kanta/STEP400/hardware/step400_test002_schematics.pdf

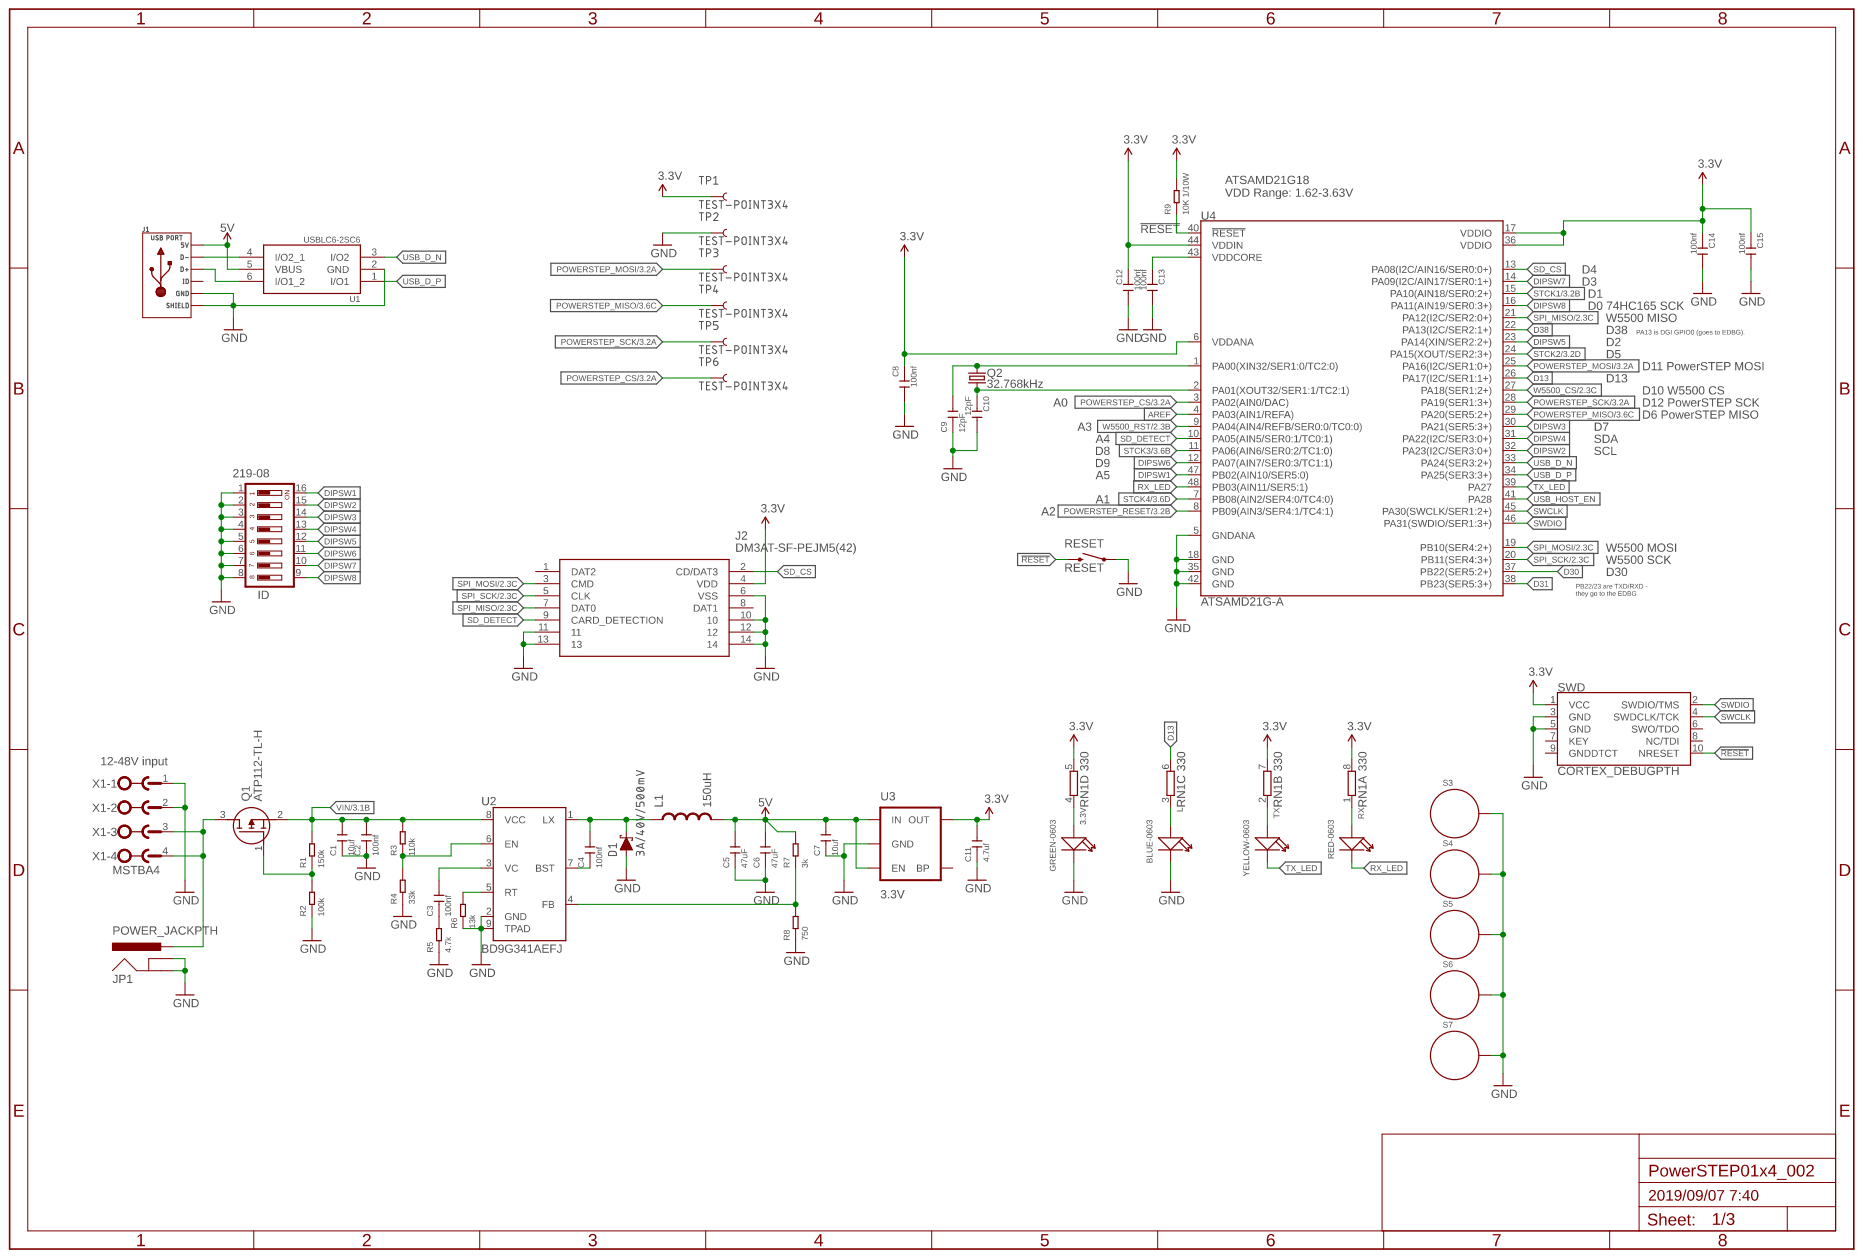
[picture p1: page 1]

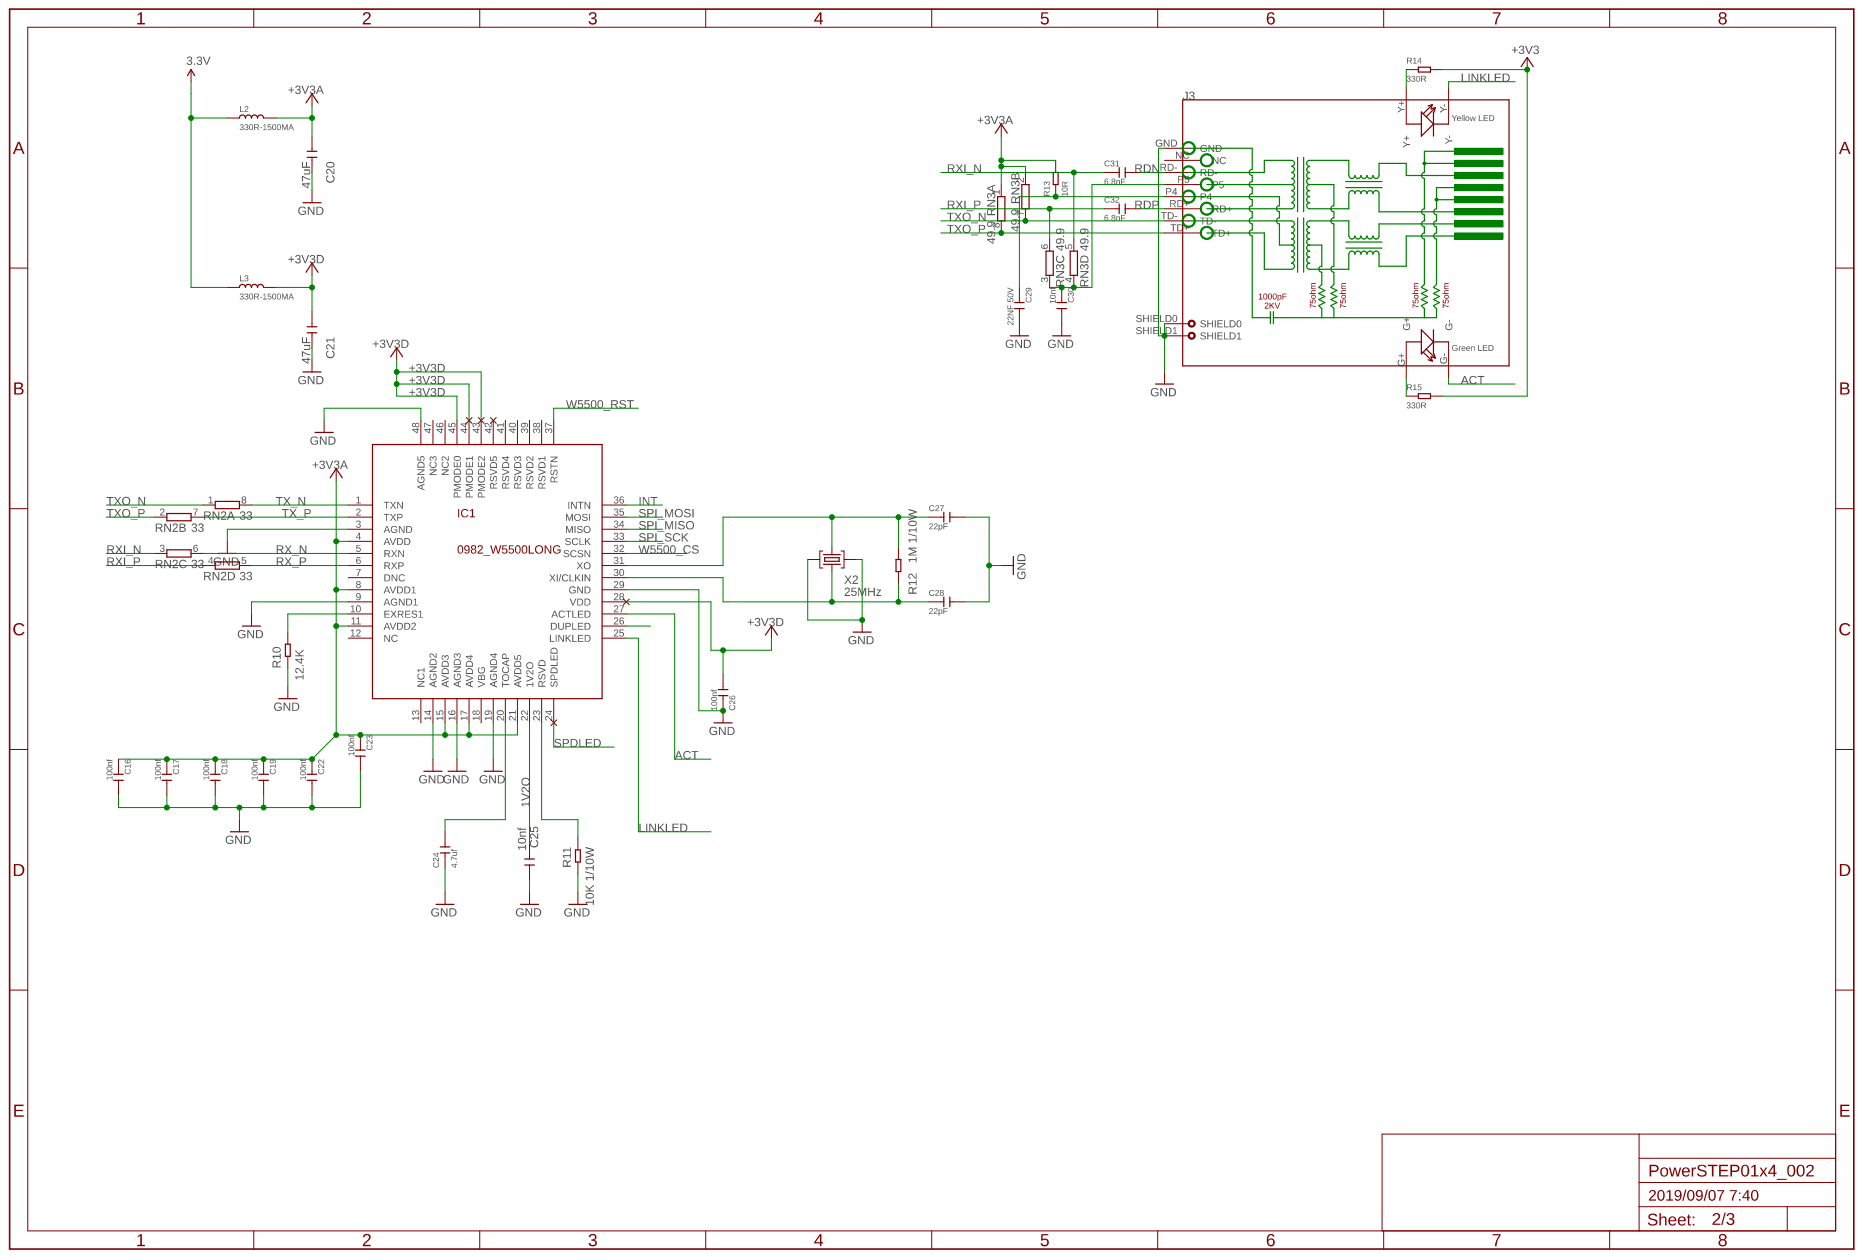
[picture p2: page 2]

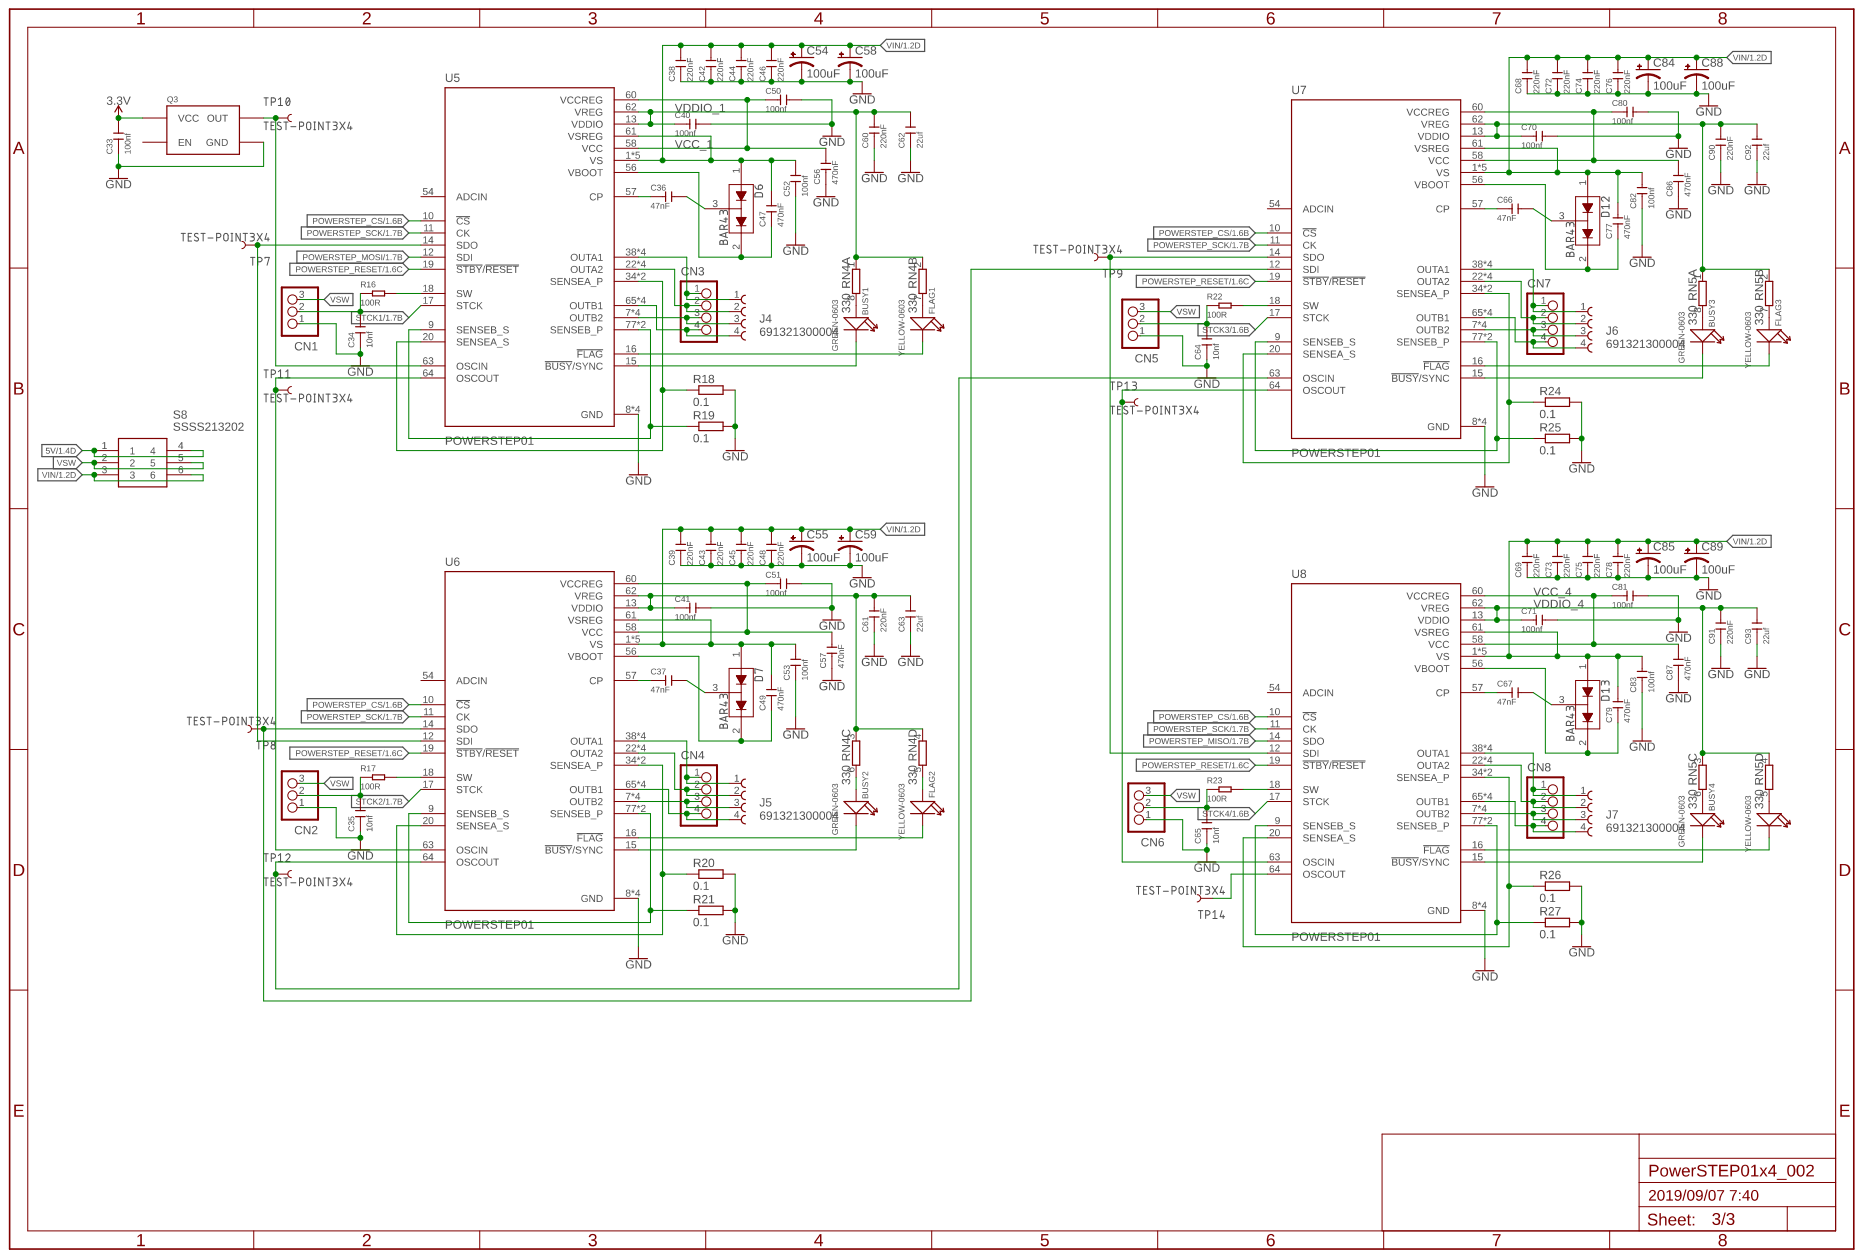
[picture p3: page 3]
