kanta/STEP400/hardware/stepper_quad_PowerSTEP01_bom.pdf

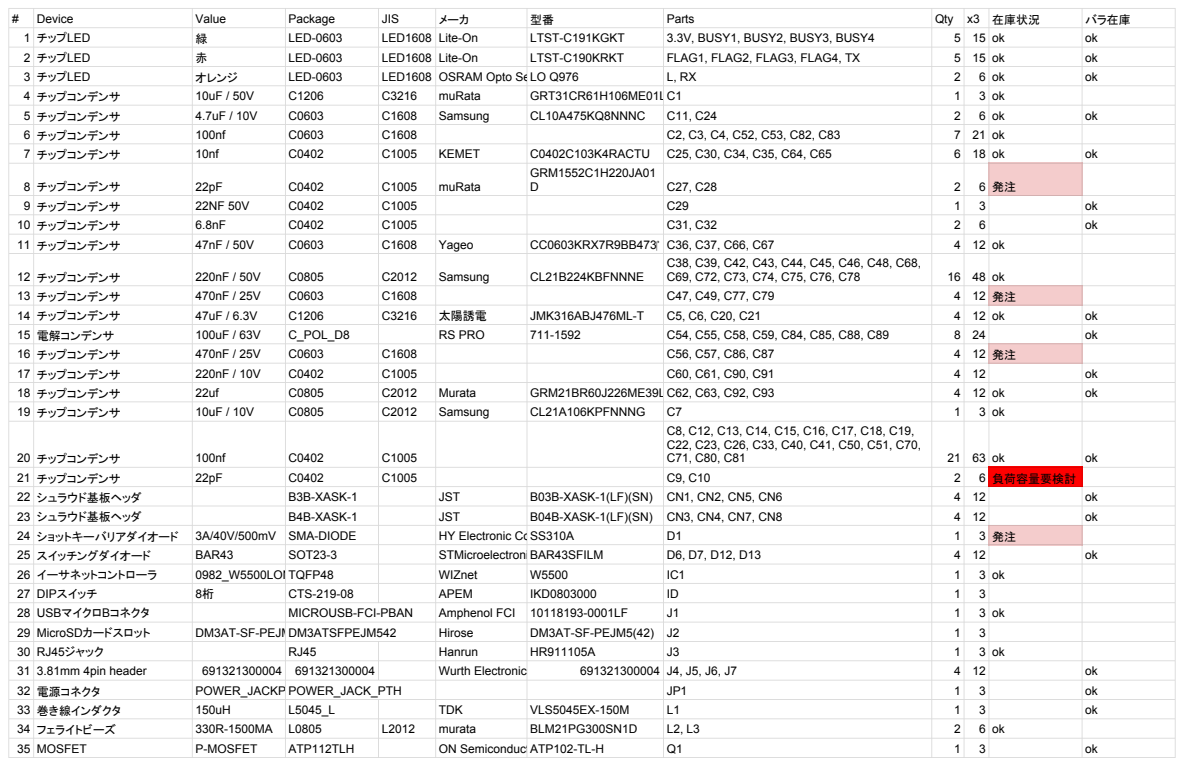
[picture p4: page 1]

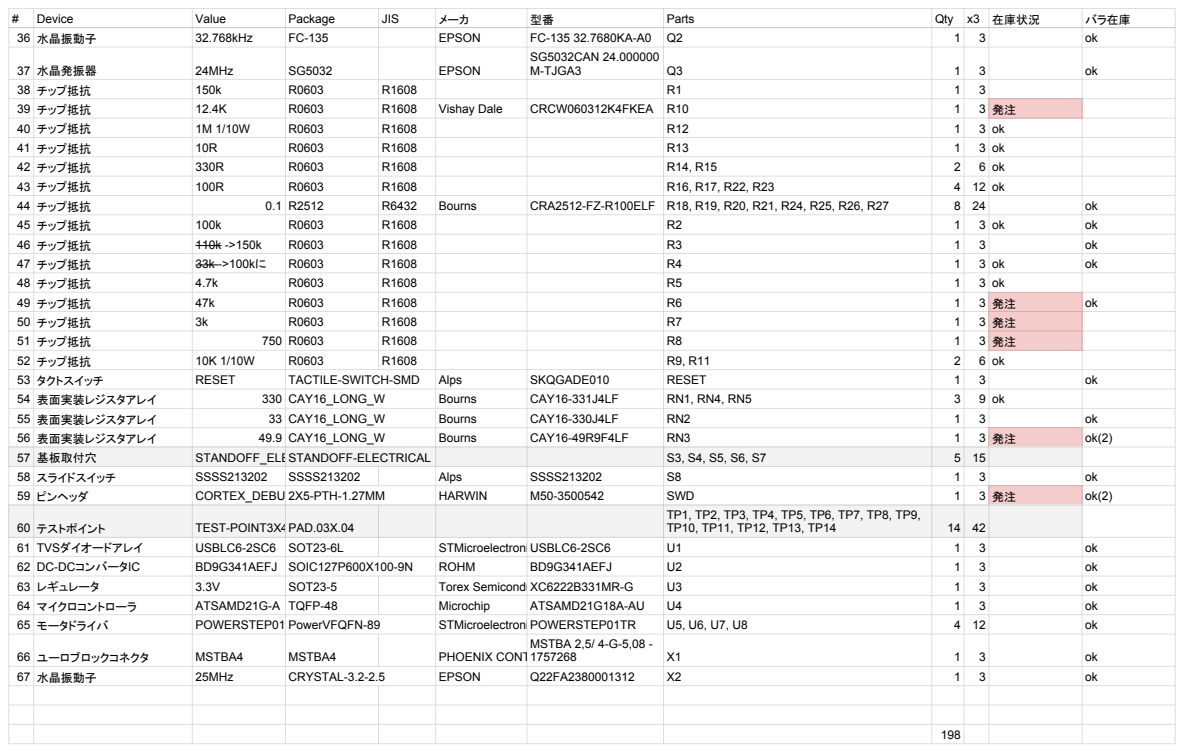
[picture p5: page 2]
