kanta/STEP400/hardware/PowerSTEP01x4_002.brd

## EAGLE design hardware/PowerSTEP01x4_002.brd (2019-09-24)

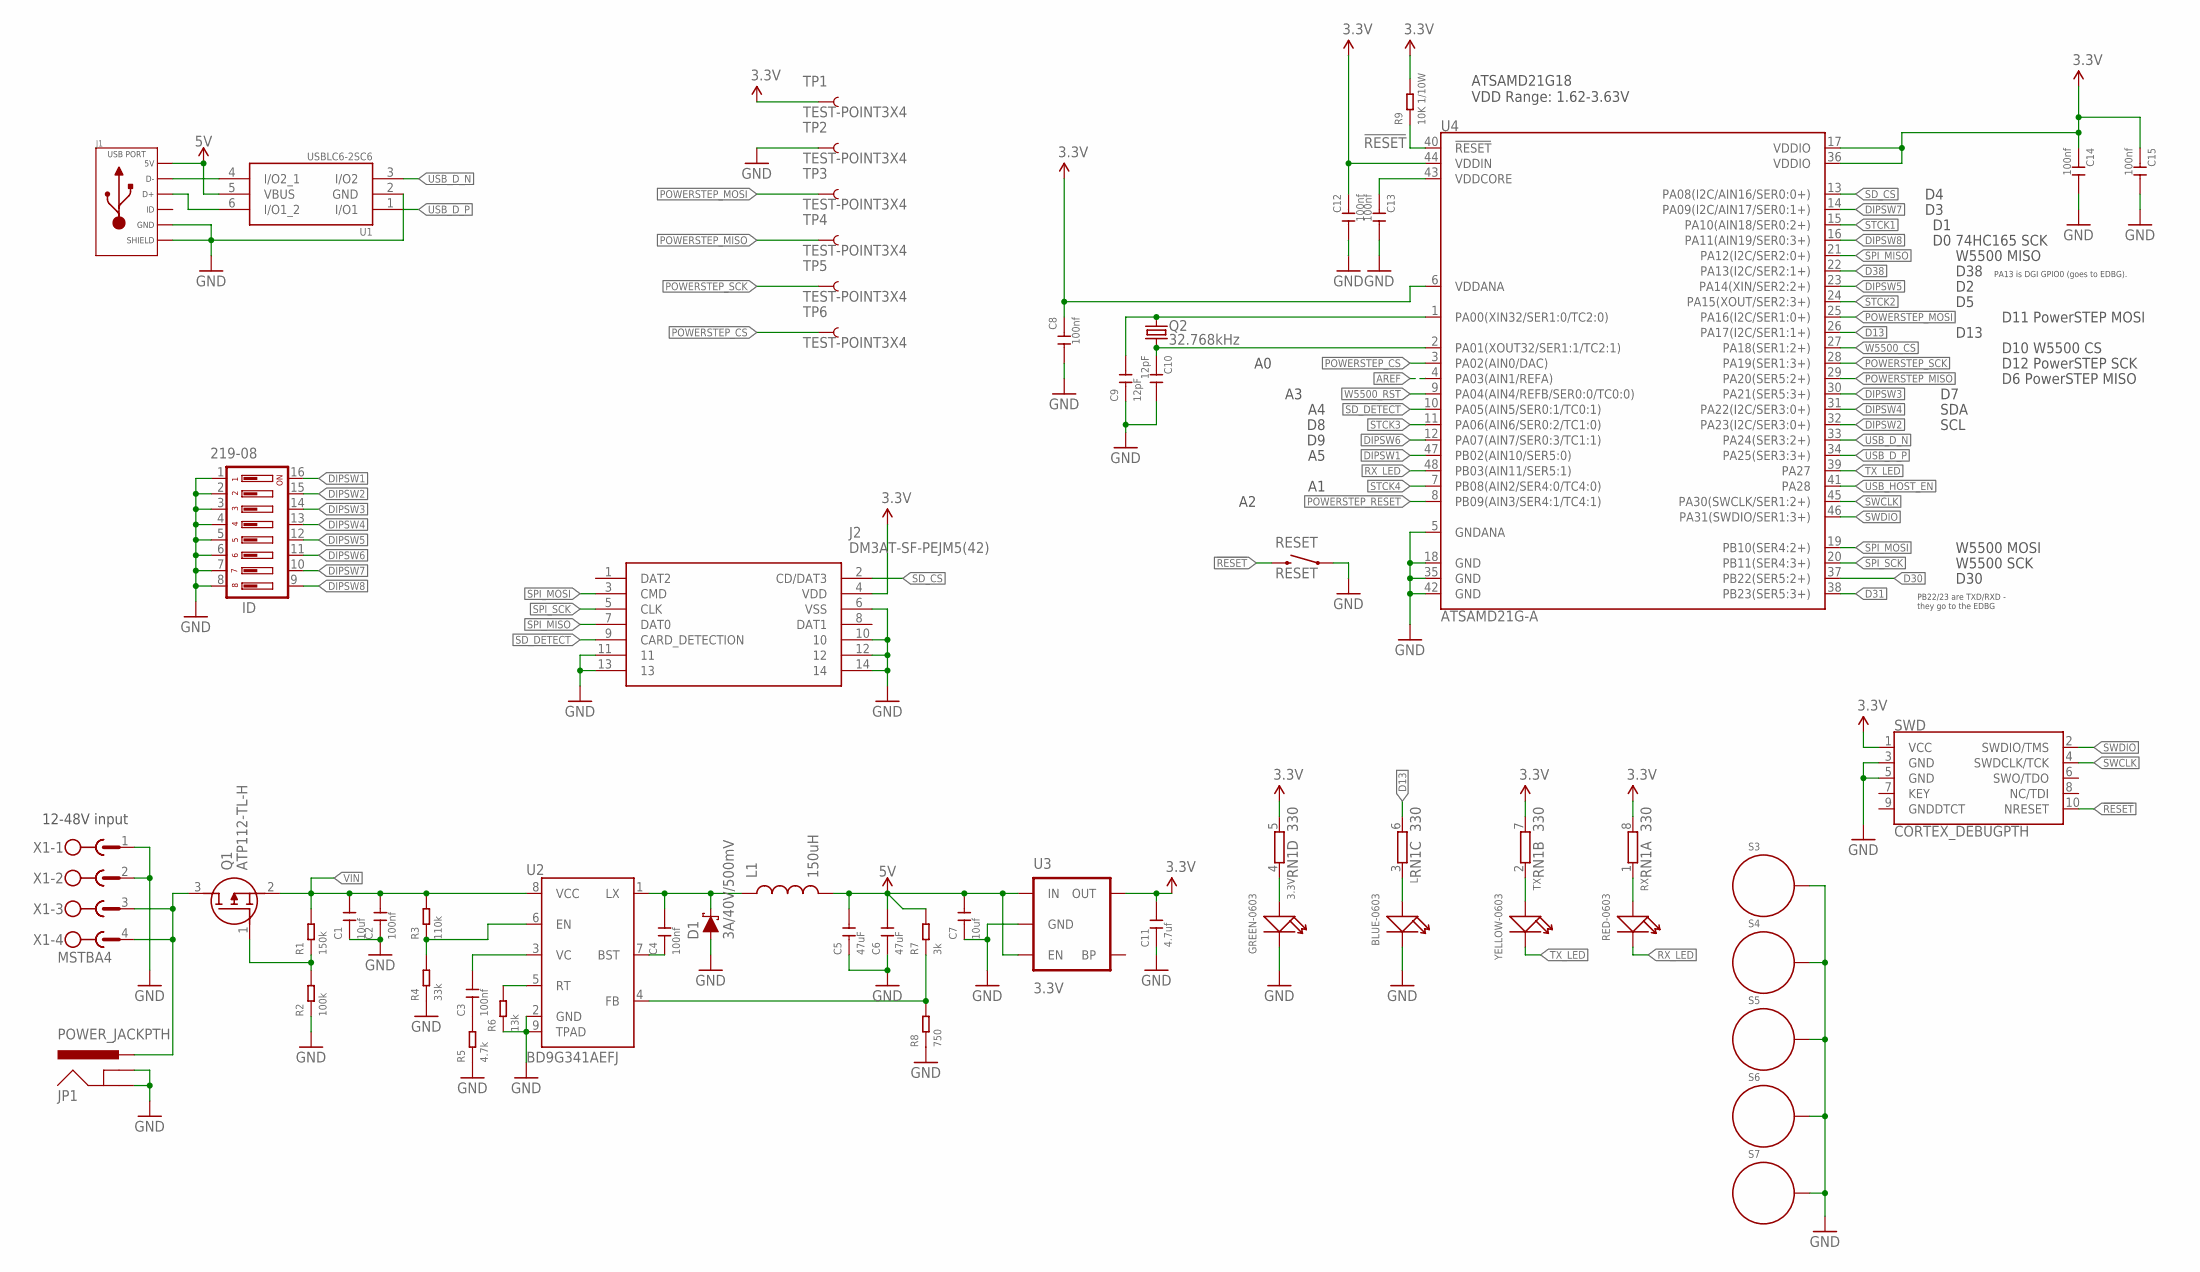
[picture p6: schematic PowerSTEP01x4_002.sch, sheet 1]

Parts:
3.3V: GREEN-0603; LED-0603
C1: 10uf; C1206
C2, C3, C4: 100nf; C0603
C5, C6: 47uF; C1206
C7: 10uf; C0805
C8, C12, C13, C14, C15: 100nf; C0402
C9, C10: 12pF; C0402
C11: 4.7uf; C0603
D1: 3A/40V/500mV; SMA-DIODE
ID: 219-08; CTS-219-08
J1: USB_MICRO_10118193-0001LF; MICROUSB-FCI-PBAN
J2: DM3AT-SF-PEJM5(42); DM3ATSFPEJM542
JP1: POWER_JACKPTH; POWER_JACK_PTH
L: BLUE-0603; LED-0603
L1: 150uH; L5045_L
Q1: ATP112-TL-H; ATP112TLH
Q2: 32.768kHz; FC-135
R1: 150k; R0603
R2: 100k; R0603
R3: 110k; R0603
R4: 33k; R0603
R5: 4.7k; R0603
R6: 13k; R0603
R7: 3k; R0603
R8: 750; R0603
R9: 10K 1/10W; R0603
RESET: RESET; TACTILE-SWITCH-SMD
RN1: 330; CAY16_LONG_W
RX: RED-0603; LED-0603
S3, S4, S5, S6, S7: STANDOFF_ELECTRICAL; STANDOFF-ELECTRICAL
SWD: CORTEX_DEBUGPTH; 2X5-PTH-1.27MM
TP1, TP2, TP3, TP4, TP5, TP6: TEST-POINT3X4; PAD.03X.04
TX: YELLOW-0603; LED-0603
U1: USBLC6-2SC6; SOT23-6L
U2: BD9G341AEFJ; SOIC127P600X100-9N
U3: 3.3V; SOT23-5
U4: ATSAMD21G-A; TQFP-48
X1: MSTBA4

Connections:
3.3V: C8.1, C11.2, C12.1, C14.1, C15.1, J2.4 (VDD), R9.2, RN1.5 (2), RN1.7 (2), RN1.8 (2), SWD.1 (VCC), TP1.P$1, U3.5 (OUT), U4.6 (VDDANA), U4.17 (VDDIO), U4.36 (VDDIO), U4.44 (VDDIN); also elsewhere on the board
5V: C5.2, C6.2, C7.2, J1.1 (5V), L1.P$2 (2), R7.2, U1.5 (VBUS), U3.1 (IN), U3.3 (EN); also elsewhere on the board
!RESET: R9.1, RESET.3 (2), SWD.10 (NRESET), U4.40 (!RESET!)
AREF: U4.4 (PA03(AIN1/REFA))
D13: RN1.6 (2), U4.26 (PA17(I2C/SER1:1+))
D30: U4.37 (PB22(SER5:2+))
D31: U4.38 (PB23(SER5:3+))
D38: U4.22 (PA13(I2C/SER2:1+))
D+: J1.3 (D+), U1.6 (I/O1_2)
DIPSW1: ID.16, U4.47 (PB02(AIN10/SER5:0))
DIPSW2: ID.15, U4.32 (PA23(I2C/SER3:0+))
DIPSW3: ID.14, U4.30 (PA21(SER5:3+))
DIPSW4: ID.13, U4.31 (PA22(I2C/SER3:0+))
DIPSW5: ID.12, U4.23 (PA14(XIN/SER2:2+))
DIPSW6: ID.11, U4.12 (PA07(AIN7/SER0:3/TC1:1))
DIPSW7: ID.10, U4.14 (PA09(I2C/AIN17/SER0:1+))
DIPSW8: ID.9, U4.16 (PA11(AIN19/SER0:3+))
GND: 3.3V.-, C1.1, C2.1, C5.1, C6.1, C7.1, C8.2, C9.1, C10.2, C11.1, C12.2, C13.2, C14.2, C15.2, D1.A, ID.1, ID.2, ID.3, ID.4, ID.5, ID.6, ID.7, ID.8, J1.5 (GND), J1.S1 (SLD), J1.S2 (SLD), J1.S3 (SLD), J1.S4 (SLD), J1.S5 (SLD), J1.S6 (SLD), J1.S7 (SLD), J1.S8 (SLD), J2.6 (VSS), J2.10, J2.11, J2.12, J2.13, J2.14, JP1.GND, JP1.GNDBREAK, L.-, R2.1, R4.1, R5.1, R6.1, R8.1, RESET.1, S3.P1, S4.P1, S5.P1, S6.P1, S7.P1, SWD.3 (GND), SWD.5 (GND), TP2.P$1, U1.2 (GND), U2.2 (GND), U2.9 (TPAD), U3.2 (GND), U4.5 (GNDANA), U4.18 (GND), U4.35 (GND), U4.42 (GND), X1.1, X1.2; also elsewhere on the board
unnamed: C9.2, Q2.P$2 (2), U4.1 (PA00(XIN32/SER1:0/TC2:0))
unnamed: C3.1, R5.2
unnamed: C10.1, Q2.P$1 (1), U4.2 (PA01(XOUT32/SER1:1/TC2:1))
unnamed: RN1.1, RX.+
unnamed: RN1.2 (1), TX.+
unnamed: R7.1, R8.2, U2.4 (FB)
unnamed: R3.1, R4.2, U2.6 (EN)
unnamed: R6.2, U2.5 (RT)
unnamed: L.+, RN1.3 (1)
unnamed: 3.3V.+, RN1.4 (1)
unnamed: C3.2, U2.3 (VC)
unnamed: C4.1, U2.7 (BST)
unnamed: C4.2, D1.C, L1.P$1 (1), U2.1 (LX)
unnamed: Q1.1 (G), R1.1, R2.2
unnamed: J1.2 (D-), U1.4 (I/O2_1)
POWERSTEP_CS: TP6.P$1, U4.3 (PA02(AIN0/DAC)); also elsewhere on the board
POWERSTEP_MISO: TP4.P$1, U4.29 (PA20(SER5:2+)); also elsewhere on the board
POWERSTEP_MOSI: TP3.P$1, U4.25 (PA16(I2C/SER1:0+)); also elsewhere on the board
POWERSTEP_RESET: U4.8 (PB09(AIN3/SER4:1/TC4:1)); also elsewhere on the board
POWERSTEP_SCK: TP5.P$1, U4.28 (PA19(SER1:3+)); also elsewhere on the board
RX_LED: RX.-, U4.48 (PB03(AIN11/SER5:1))
SD_CS: J2.2 (CD/DAT3), U4.13 (PA08(I2C/AIN16/SER0:0+))
SD_DETECT: J2.9 (CARD_DETECTION), U4.10 (PA05(AIN5/SER0:1/TC0:1))
SPI_MISO: J2.7 (DAT0), U4.21 (PA12(I2C/SER2:0+)); also elsewhere on the board
SPI_MOSI: J2.3 (CMD), U4.19 (PB10(SER4:2+)); also elsewhere on the board
SPI_SCK: J2.5 (CLK), U4.20 (PB11(SER4:3+)); also elsewhere on the board
STCK1: U4.15 (PA10(AIN18/SER0:2+)); also elsewhere on the board
STCK2: U4.24 (PA15(XOUT/SER2:3+)); also elsewhere on the board
STCK3: U4.11 (PA06(AIN6/SER0:2/TC1:0)); also elsewhere on the board
STCK4: U4.7 (PB08(AIN2/SER4:0/TC4:0)); also elsewhere on the board
SWCLK: SWD.4 (SWDCLK/TCK), U4.45 (PA30(SWCLK/SER1:2+))
SWDIO: SWD.2 (SWDIO/TMS), U4.46 (PA31(SWDIO/SER1:3+))
TX_LED: TX.-, U4.39 (PA27)
USB_D_N: U1.3 (I/O2), U4.33 (PA24(SER3:2+))
USB_D_P: U1.1 (I/O1), U4.34 (PA25(SER3:3+))
USB_HOST_EN: U4.41 (PA28)
VDDCORE: C13.1, U4.43 (VDDCORE)
VIN: C1.2, C2.2, Q1.2 (S), R1.2, R3.2, U2.8 (VCC); also elsewhere on the board
VRAW: JP1.PWR, Q1.3 (D), X1.3, X1.4
W5500_CS: U4.27 (PA18(SER1:2+)); also elsewhere on the board
W5500_RST: U4.9 (PA04(AIN4/REFB/SER0:0/TC0:0)); also elsewhere on the board

Notes on the sheet:
PB22/23 are TXD/RXD - they go to the EDBG
PA13 is DGI GPIO0 (goes to EDBG).
ATSAMD21G18 VDD Range: 1.62-3.63V
D30
D12 PowerSTEP SCK
D10 W5500 CS
D11 PowerSTEP MOSI
D13
D6 PowerSTEP MISO
D38
D0 74HC165 SCK
12-48V input
W5500 MISO
W5500 MOSI
W5500 SCK
SDA
SCL

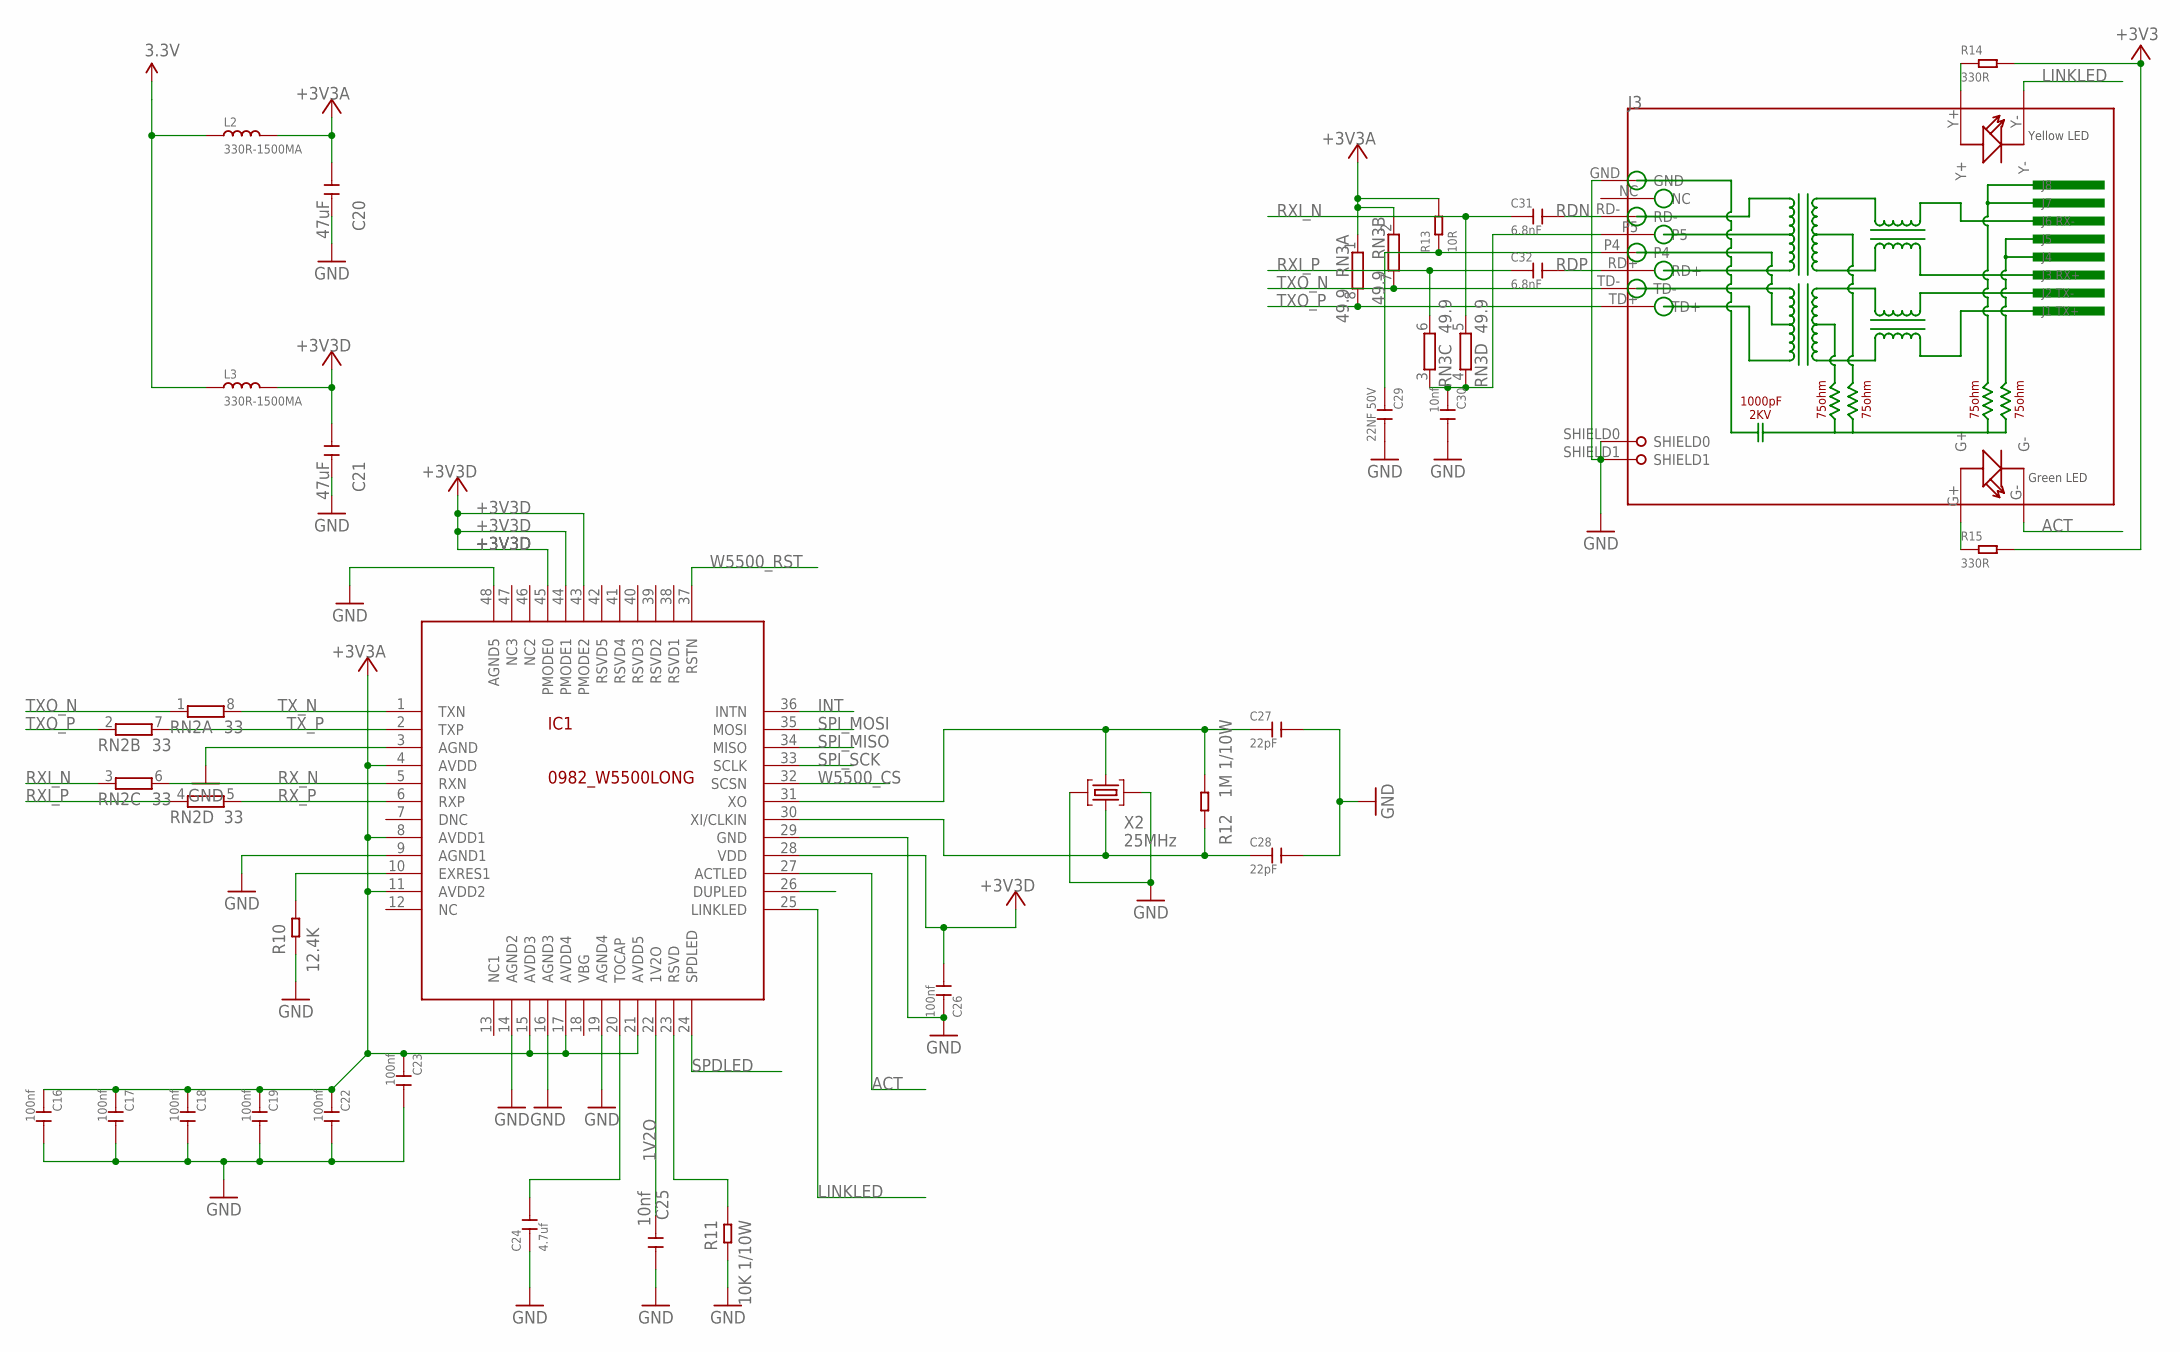
[picture p7: schematic PowerSTEP01x4_002.sch, sheet 2]

Parts:
C16, C17, C18, C19, C22, C23, C26: 100nf; C0402
C20, C21: 47uF; C1206
C24: 4.7uf; C0603
C25, C30: 10nf; C0402
C27, C28: 22pF; C0402
C29: 22NF 50V; C0402
C31, C32: 6.8nF; C0402
IC1: 0982_W5500LONG; TQFP48-LONG
J3: RJ45-HR911105A-HR911105A; RJ45
L2, L3: 330R-1500MA; L0805
R10: 12.4K; R0603
R11: 10K 1/10W; R0603
R12: 1M 1/10W; R0603
R13: 10R; R0603
R14, R15: 330R; R0603
RN2: 33; CAY16_LONG_W
RN3: 49.9; CAY16_LONG_W
X2: 25MHz; CRYSTAL-3.2-2.5

Connections:
1V2O: C25.2, IC1.22 (1V2O)
3.3V: L2.1, L3.1, R14.2, R15.2; also elsewhere on the board
+3V3A: C16.1, C17.1, C18.1, C19.1, C20.1, C22.1, C23.1, IC1.4 (AVDD), IC1.8 (AVDD1), IC1.11 (AVDD2), IC1.15 (AVDD3), IC1.17 (AVDD4), IC1.21 (AVDD5), L2.2, R13.2, RN3.1, RN3.2 (1)
+3V3D: C21.1, C26.2, IC1.28 (VDD), IC1.43 (PMODE2), IC1.44 (PMODE1), IC1.45 (PMODE0), L3.2
ACT: IC1.27 (ACTLED), J3.G-
FDXLED: IC1.26 (DUPLED)
GND: C16.2, C17.2, C18.2, C19.2, C20.2, C21.2, C22.2, C23.2, C24.1, C25.1, C26.1, C27.2, C28.2, C29.2, C30.2, IC1.3 (AGND), IC1.9 (AGND1), IC1.14 (AGND2), IC1.16 (AGND3), IC1.19 (AGND4), IC1.29 (GND), IC1.48 (AGND5), J3.GND, J3.SHIELD0, J3.SHIELD1, R10.1, R11.1, X2.2 (GND), X2.4 (GND); also elsewhere on the board
INT: IC1.36 (INTN)
LINKLED: IC1.25 (LINKLED), J3.Y-
unnamed: C27.1, IC1.31 (XO), R12.1, X2.3 (C2)
unnamed: C29.1, J3.P4, R13.1
unnamed: C30.1, J3.P5, RN3.3 (1), RN3.4 (1)
unnamed: J3.Y+, R14.1
unnamed: J3.G+, R15.1
unnamed: IC1.23 (RSVD), R11.2
unnamed: C24.2, IC1.20 (TOCAP)
unnamed: IC1.10 (EXRES1), R10.2
NC: IC1.12 (NC)
OSC2E2: C28.1, IC1.30 (XI/CLKIN), R12.2, X2.1 (C1)
RDN: C31.2, J3.RD-
RDP: C32.2, J3.RD+
RSVD1: IC1.38 (RSVD1)
RSVD2: IC1.39 (RSVD2)
RSVD3: IC1.40 (RSVD3)
RXI_N: C31.1, RN2.3 (1), RN3.5 (2)
RXI_P: C32.1, RN2.4 (1), RN3.6 (2)
RX_N: IC1.5 (RXN), RN2.6 (2)
RX_P: IC1.6 (RXP), RN2.5 (2)
SPDLED: IC1.24 (SPDLED)
SPI_MISO: IC1.34 (MISO); also elsewhere on the board
SPI_MOSI: IC1.35 (MOSI); also elsewhere on the board
SPI_SCK: IC1.33 (SCLK); also elsewhere on the board
TXO_N: J3.TD-, RN2.1, RN3.7 (2)
TXO_P: J3.TD+, RN2.2 (1), RN3.8 (2)
TX_N: IC1.1 (TXN), RN2.8 (2)
TX_P: IC1.2 (TXP), RN2.7 (2)
W5500_CS: IC1.32 (SCSN); also elsewhere on the board
W5500_RST: IC1.37 (RSTN); also elsewhere on the board

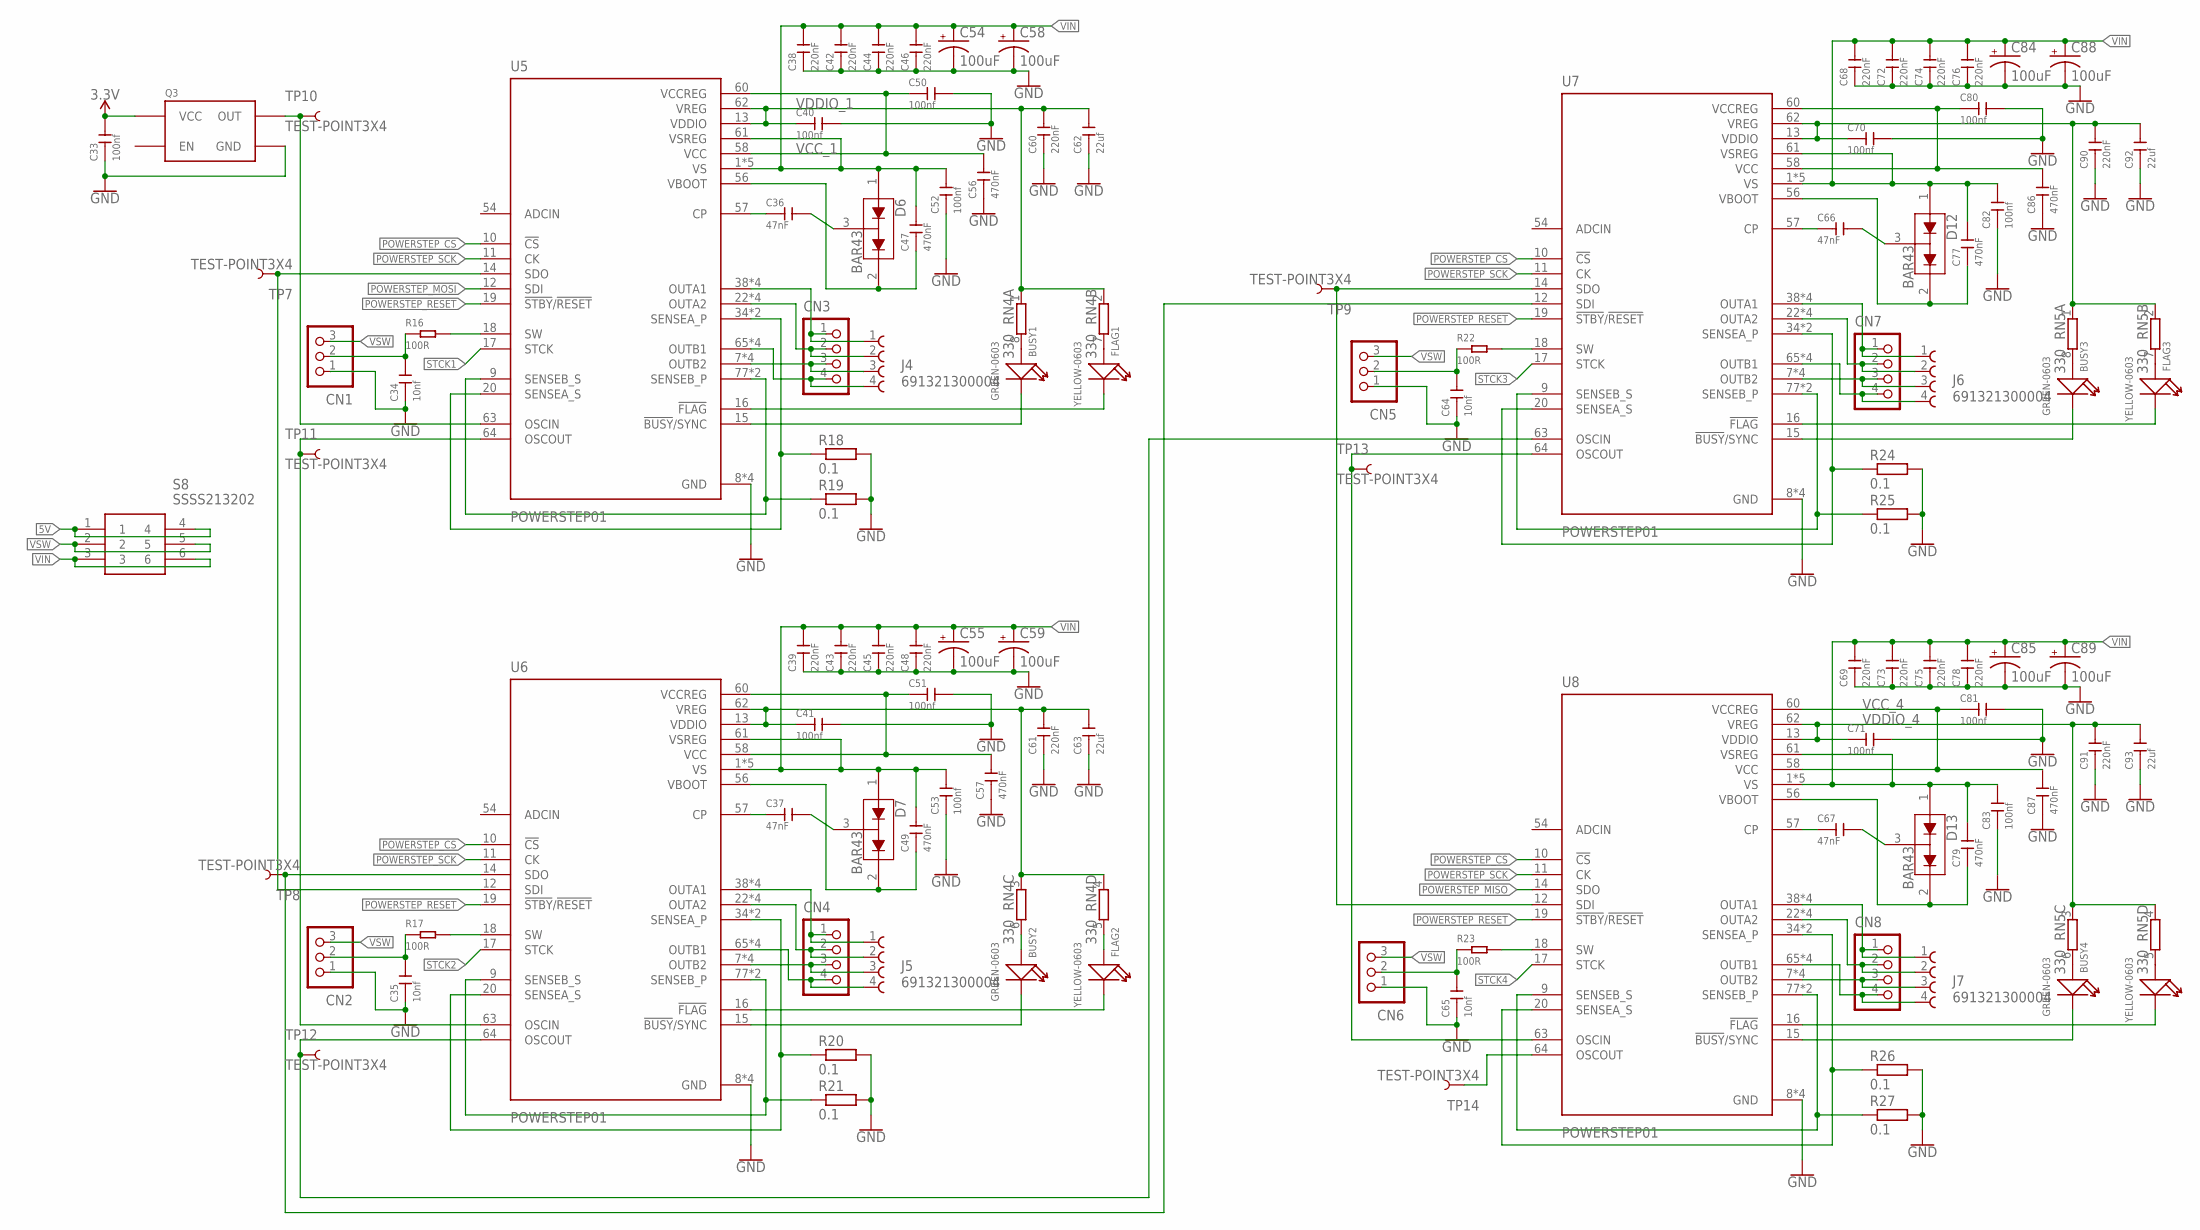
[picture p8: schematic PowerSTEP01x4_002.sch, sheet 3]

Parts:
BUSY1, BUSY2, BUSY3, BUSY4: GREEN-0603; LED-0603
C33, C40, C41, C50, C51, C70, C71, C80, C81: 100nf; C0402
C34, C35, C64, C65: 10nf; C0402
C36, C37, C66, C67: 47nF; C0603
C38, C39, C42, C43, C44, C45, C46, C48, C68, C69, C72, C73, C74, C75, C76, C78: 220nF; C0805
C47, C49, C56, C57, C77, C79, C86, C87: 470nF; C0603
C52, C53, C82, C83: 100nf; C0603
C54, C55, C58, C59, C84, C85, C88, C89: 100uF; C_POL_D8
C60, C61, C90, C91: 220nF; C0402
C62, C63, C92, C93: 22uf; C0805
CN1, CN2, CN5, CN6: B3B-XASK-1
CN3, CN4, CN7, CN8: B4B-XASK-1
D6, D7, D12, D13: BAR43; SOT23-3
FLAG1, FLAG2, FLAG3, FLAG4: YELLOW-0603; LED-0603
J4, J5, J6, J7: 691321300004
Q3: CRYSTAL_OSC_SG5032; SG5032
R16, R17, R22, R23: 100R; R0603
R18, R19, R20, R21, R24, R25, R26, R27: 0.1; RESC6332X71N
RN4, RN5: 330; CAY16_LONG_W
S8: SSSS213202
TP7, TP8, TP9, TP10, TP11, TP12, TP13, TP14: TEST-POINT3X4; PAD.03X.04
U5, U6, U7, U8: POWERSTEP01; IC_POWERSTEP01

Connections:
3.3V: C33.2, Q3.4 (VCC); also elsewhere on the board
5V: S8.1, S8.4; also elsewhere on the board
GND: C33.1, C34.1, C35.1, C38.1, C39.1, C40.2, C41.2, C42.1, C43.1, C44.1, C45.1, C46.1, C48.1, C50.2, C51.2, C52.1, C53.1, C54.-, C55.-, C56.1, C57.1, C58.-, C59.-, C60.1, C61.1, C62.1, C63.1, C64.1, C65.1, C68.1, C69.1, C70.2, C71.2, C72.1, C73.1, C74.1, C75.1, C76.1, C78.1, C80.2, C81.2, C82.1, C83.1, C84.-, C85.-, C86.1, C87.1, C88.-, C89.-, C90.1, C91.1, C92.1, C93.1, CN1.1, CN2.1, CN5.1, CN6.1, Q3.2 (GND), R18.2, R19.2, R20.2, R21.2, R24.2, R25.2, R26.2, R27.2, U5.8 (GND), U5.21 (GND), U5.59 (GND), U5.EPAD9 (GND), U6.8 (GND), U6.21 (GND), U6.59 (GND), U6.EPAD9 (GND), U7.8 (GND), U7.21 (GND), U7.59 (GND), U7.EPAD9 (GND), U8.8 (GND), U8.21 (GND), U8.59 (GND), U8.EPAD9 (GND); also elsewhere on the board
unnamed: TP14.P$1, U8.64 (OSCOUT)
unnamed: BUSY1.+, RN4.8 (2)
unnamed: FLAG1.+, RN4.7 (2)
unnamed: C36.2, D6.3 (COM)
unnamed: C36.1, U5.57 (CP)
unnamed: BUSY2.+, RN4.6 (2)
unnamed: FLAG2.+, RN4.5 (2)
unnamed: FLAG1.-, U5.16 (!FLAG)
unnamed: BUSY1.-, U5.15 (!BUSY!/SYNC)
unnamed: R19.1, U5.9 (SENSEB_S), U5.77 (SENSEB_P), U5.82 (SENSEB_P)
unnamed: R18.1, U5.20 (SENSEA_S), U5.34 (SENSEA_P), U5.39 (SENSEA_P)
unnamed: R16.2, U5.18 (SW)
unnamed: C34.2, CN1.2, R16.1
unnamed: CN3.1, J4.1, U5.38 (OUTA1), U5.42 (OUTA1), U5.53 (OUTA1), U5.EPAD4 (OUTA1)
unnamed: CN3.2, J4.2, U5.22 (OUTA2), U5.33 (OUTA2), U5.37 (OUTA2), U5.EPAD3 (OUTA2)
unnamed: TP7.P$1, U5.14 (SDO), U6.12 (SDI)
unnamed: CN3.3, J4.3, U5.7 (OUTB2), U5.81 (OUTB2), U5.85 (OUTB2), U5.EPAD8 (OUTB2)
unnamed: CN3.4, J4.4, U5.65 (OUTB1), U5.76 (OUTB1), U5.80 (OUTB1), U5.EPAD7 (OUTB1)
unnamed: C37.2, D7.3 (COM)
unnamed: C37.1, U6.57 (CP)
unnamed: BUSY3.+, RN5.8 (2)
unnamed: FLAG3.+, RN5.7 (2)
unnamed: FLAG2.-, U6.16 (!FLAG)
unnamed: BUSY2.-, U6.15 (!BUSY!/SYNC)
unnamed: R21.1, U6.9 (SENSEB_S), U6.77 (SENSEB_P), U6.82 (SENSEB_P)
unnamed: R20.1, U6.20 (SENSEA_S), U6.34 (SENSEA_P), U6.39 (SENSEA_P)
unnamed: R17.2, U6.18 (SW)
unnamed: TP12.P$1, U6.64 (OSCOUT), U7.63 (OSCIN)
unnamed: CN4.1, J5.1, U6.38 (OUTA1), U6.42 (OUTA1), U6.53 (OUTA1), U6.EPAD4 (OUTA1)
unnamed: CN4.2, J5.2, U6.22 (OUTA2), U6.33 (OUTA2), U6.37 (OUTA2), U6.EPAD3 (OUTA2)
unnamed: CN4.3, J5.3, U6.7 (OUTB2), U6.81 (OUTB2), U6.85 (OUTB2), U6.EPAD8 (OUTB2)
unnamed: CN4.4, J5.4, U6.65 (OUTB1), U6.76 (OUTB1), U6.80 (OUTB1), U6.EPAD7 (OUTB1)
unnamed: C35.2, CN2.2, R17.1
unnamed: BUSY4.+, RN5.6 (2)
unnamed: C77.1, D12.2 (C2), U7.56 (VBOOT)
unnamed: C66.2, D12.3 (COM)
unnamed: C66.1, U7.57 (CP)
unnamed: FLAG4.+, RN5.5 (2)
unnamed: CN7.4, J6.4, U7.65 (OUTB1), U7.76 (OUTB1), U7.80 (OUTB1), U7.EPAD7 (OUTB1)
unnamed: FLAG3.-, U7.16 (!FLAG)
unnamed: BUSY3.-, U7.15 (!BUSY!/SYNC)
unnamed: R25.1, U7.9 (SENSEB_S), U7.77 (SENSEB_P), U7.82 (SENSEB_P)
unnamed: R24.1, U7.20 (SENSEA_S), U7.34 (SENSEA_P), U7.39 (SENSEA_P)
unnamed: R22.2, U7.18 (SW)
unnamed: TP8.P$1, U6.14 (SDO), U7.12 (SDI)
unnamed: CN7.1, J6.1, U7.38 (OUTA1), U7.42 (OUTA1), U7.53 (OUTA1), U7.EPAD4 (OUTA1)
unnamed: CN7.2, J6.2, U7.22 (OUTA2), U7.33 (OUTA2), U7.37 (OUTA2), U7.EPAD3 (OUTA2)
unnamed: CN7.3, J6.3, U7.7 (OUTB2), U7.81 (OUTB2), U7.85 (OUTB2), U7.EPAD8 (OUTB2)
unnamed: CN8.4, J7.4, U8.65 (OUTB1), U8.76 (OUTB1), U8.80 (OUTB1), U8.EPAD7 (OUTB1)
unnamed: C64.2, CN5.2, R22.1
unnamed: CN8.3, J7.3, U8.7 (OUTB2), U8.81 (OUTB2), U8.85 (OUTB2), U8.EPAD8 (OUTB2)
unnamed: C79.1, D13.2 (C2), U8.56 (VBOOT)
unnamed: C67.2, D13.3 (COM)
unnamed: C67.1, U8.57 (CP)
unnamed: FLAG4.-, U8.16 (!FLAG)
unnamed: BUSY4.-, U8.15 (!BUSY!/SYNC)
unnamed: R27.1, U8.9 (SENSEB_S), U8.77 (SENSEB_P), U8.82 (SENSEB_P)
unnamed: R26.1, U8.20 (SENSEA_S), U8.34 (SENSEA_P), U8.39 (SENSEA_P)
unnamed: R23.2, U8.18 (SW)
unnamed: CN8.1, J7.1, U8.38 (OUTA1), U8.42 (OUTA1), U8.53 (OUTA1), U8.EPAD4 (OUTA1)
unnamed: CN8.2, J7.2, U8.22 (OUTA2), U8.33 (OUTA2), U8.37 (OUTA2), U8.EPAD3 (OUTA2)
unnamed: C65.2, CN6.2, R23.1
unnamed: Q3.3 (OUT), TP10.P$1, U5.63 (OSCIN)
unnamed: TP11.P$1, U5.64 (OSCOUT), U6.63 (OSCIN)
unnamed: TP13.P$1, U7.64 (OSCOUT), U8.63 (OSCIN)
unnamed: TP9.P$1, U7.14 (SDO), U8.12 (SDI)
POWERSTEP_CS: U5.10 (!CS), U6.10 (!CS), U7.10 (!CS), U8.10 (!CS); also elsewhere on the board
POWERSTEP_MISO: U8.14 (SDO); also elsewhere on the board
POWERSTEP_MOSI: U5.12 (SDI); also elsewhere on the board
POWERSTEP_RESET: U5.19 (!STBY!/!RESET), U6.19 (!STBY!/!RESET), U7.19 (!STBY!/!RESET), U8.19 (!STBY!/!RESET); also elsewhere on the board
POWERSTEP_SCK: U5.11 (CK), U6.11 (CK), U7.11 (CK), U8.11 (CK); also elsewhere on the board
STCK1: U5.17 (STCK); also elsewhere on the board
STCK2: U6.17 (STCK); also elsewhere on the board
STCK3: U7.17 (STCK); also elsewhere on the board
STCK4: U8.17 (STCK); also elsewhere on the board
VBOOT_1: C47.1, D6.2 (C2), U5.56 (VBOOT)
VBOOT_2: C49.1, D7.2 (C2), U6.56 (VBOOT)
VCC_1: C50.1, C56.2, U5.58 (VCC), U5.60 (VCCREG)
VCC_2: C51.1, C57.2, U6.58 (VCC), U6.60 (VCCREG)
VCC_3: C80.1, C86.2, U7.58 (VCC), U7.60 (VCCREG)
VCC_4: C81.1, C87.2, U8.58 (VCC), U8.60 (VCCREG)
VDDIO_1: C40.1, C60.2, C62.2, RN4.1, RN4.2 (1), U5.13 (VDDIO), U5.62 (VREG)
VDDIO_2: C41.1, C61.2, C63.2, RN4.3 (1), RN4.4 (1), U6.13 (VDDIO), U6.62 (VREG)
VDDIO_3: C70.1, C90.2, C92.2, RN5.1, RN5.2 (1), U7.13 (VDDIO), U7.62 (VREG)
VDDIO_4: C71.1, C91.2, C93.2, RN5.3 (1), RN5.4 (1), U8.13 (VDDIO), U8.62 (VREG)
VIN: C38.2, C39.2, C42.2, C43.2, C44.2, C45.2, C46.2, C47.2, C48.2, C49.2, C52.2, C53.2, C54.+, C55.+, C58.+, C59.+, C68.2, C69.2, C72.2, C73.2, C74.2, C75.2, C76.2, C77.2, C78.2, C79.2, C82.2, C83.2, C84.+, C85.+, C88.+, C89.+, D6.1 (A1), D7.1 (A1), D12.1 (A1), D13.1 (A1), S8.3, S8.6, U5.1 (VS), U5.23 (VS), U5.43 (VS), U5.55 (VS), U5.61 (VSREG), U5.66 (VS), U6.1 (VS), U6.23 (VS), U6.43 (VS), U6.55 (VS), U6.61 (VSREG), U6.66 (VS), U7.1 (VS), U7.23 (VS), U7.43 (VS), U7.55 (VS), U7.61 (VSREG), U7.66 (VS), U8.1 (VS), U8.23 (VS), U8.43 (VS), U8.55 (VS), U8.61 (VSREG), U8.66 (VS); also elsewhere on the board
VSW: CN1.3, CN2.3, CN5.3, CN6.3, S8.2, S8.5

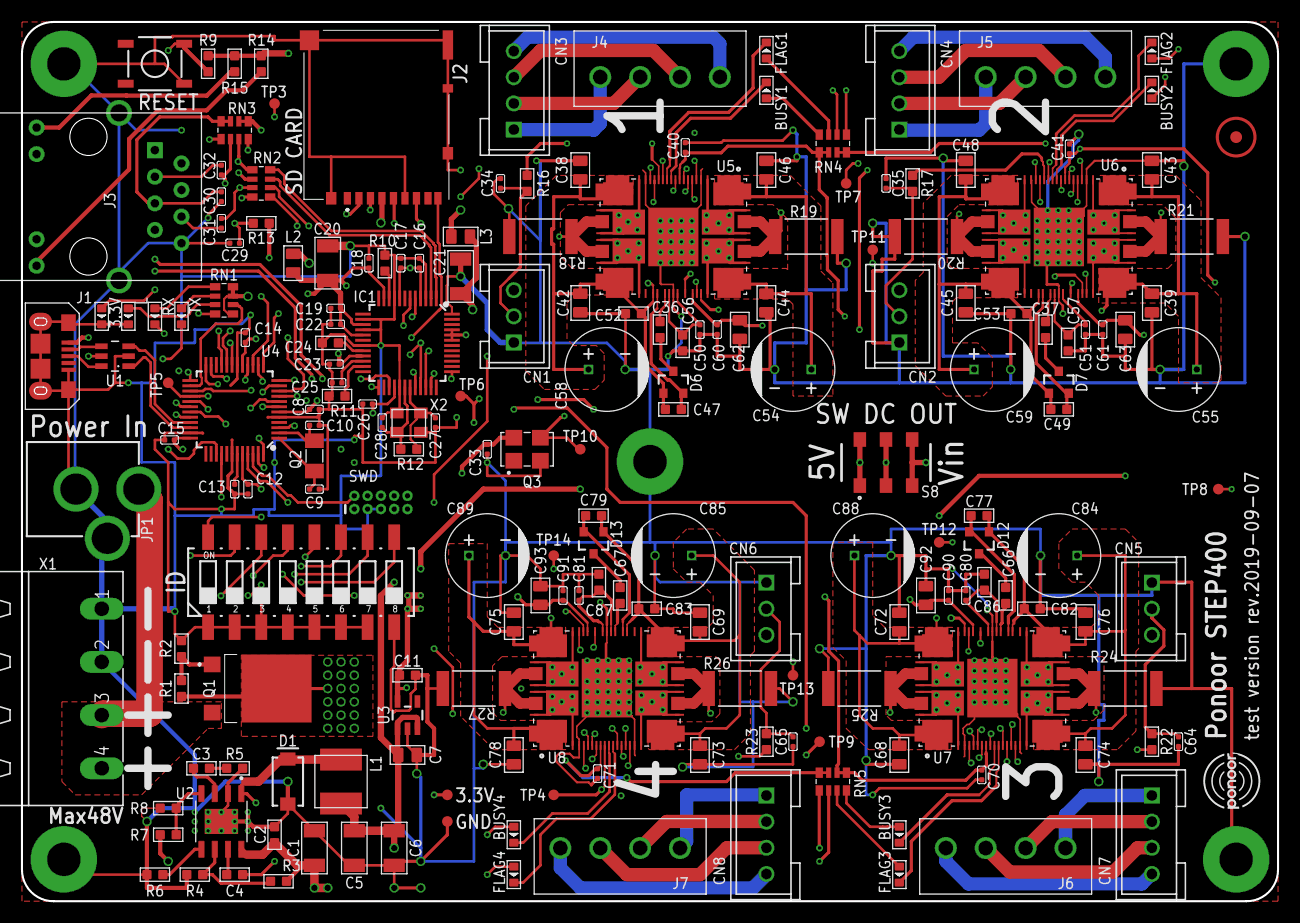
[picture p9: board PowerSTEP01x4_002.brd from above]

Board: 4 copper layers, 120.0 x 84.0 mm, 200 parts (0 on the bottom side), 155 nets.

Other parts of the board:
U$1: FIDUCIAL_MARKER_PBAN
U$3: PONOOR_LOGO_6MM
