kanta/STEP400/(commit log)

2019-09-24 initial commit.
    [PowerSTEP01x4_002.brd, PowerSTEP01x4_002.sch]
2019-10-18 ライブラリをローカルにしてサブモジュール化
2019-10-18 基本的なコマンドをOSCからたたけるように
2019-10-18 スイッチテスト スラッシュわすれ
2019-10-24 定電流制御のコマンドついか
2019-10-28 gitmodulesをhttpsに
2019-10-28 毎フレームget statusする
2019-10-28 git modkules に branch master ついか
2019-10-29 [nipkow] step400_OSCtester.inoのステータス変更しました。
2019-10-30 [debug] デバッグ用ブランチ作成、Arduino IDEでコンパイルできるようにファイル移動しました。
2019-10-30 [debug] 最後の方が0だったら表示、という風にした
2019-10-31 [debug] とりあえず
2019-10-31 [debug] 多数決/重要な値を拾いたい方式を実装しました。
2019-10-31 [debug] SPIの速さを元に戻しました(4MHz)
2019-11-08 getSw getBusy setSwMode getSwModeついか
2019-11-08 serial.biginしなくてもUSBの接続が問題だった ストリクトにもどす
2019-11-12 svnモーター基板w5500リセット
